patlab-ucsd/artemia_hardware/(threads)

Thread 1 (2024-05-21):

SWD header is mirrored!

gemarcano, 2024-05-21:
Workaround: mount it below the board.

What it is right now:
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

What it's supposed to be:
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

Closed 2024-11-22.

Thread 2 (2024-05-22):

Pin out some GPIOs for general purpose use/workarounds

gemarcano, 2024-05-22:
It'd be nice to have at least some GPIOs for testing purposes and bootloader workarounds pinned out...

Thread 3 (2024-05-22):

Explore giving every major region it's own individual ground plane for power measurement purposes

gemarcano, 2024-05-22:
Our RocketLoggers do best in low-side power sensing, which means we need to monitor the current in the return path. To do this, we need to effectively isolate the grounds of every major component.

How do we link up all of the grounds? Other than at a single point, just have them join some central "main" ground?

ppannuto, 2024-05-22:
The imix board ( https://github.com/helena-project/imix ) had separably measurable power for subsystems (radio, crypto stuff, core, maybe others IIRC) and can be a reference example of how to do this

ppannuto, 2024-05-22:
You can ping hudson on tock slack at some point as well if you have any specific design questions — he spent a rev or two getting all that right if memory serves

gemarcano, 2024-11-26:
I'm actually thinking about doing this by modularizing the board a little for lab use. Specifically, all of the SPI bus components can probably be uplifted to their own breakout/PCBs that plug into the motherboard. This makes it possible to also swap out things on the bus, and facilitates measuring the current of those peripherals. I'm also thinking of doing something similar for the input power areas.

For the larger/mother board, I'd probably do something like what Janet did for her board, where major areas are in their own ground planes, and they all converge at a point, allowing for low-side power measurements.

Thread 5 (2024-06-05):

Should we place the artemia firmware in the same repository as the hardware?

gemarcano, 2024-06-05:
I've done this before with other projects, as I find that it makes some sense. We can pull in the software via `git subtree` at a later date if we so choose.

ppannuto, 2024-06-05:
I usually find monorepos the way to go usually until proven necessary to do otherwise (in which case filter-tree can undo :) )

Thread 6 (2024-06-25):

Pulldown resistors on open-drain lines are causing issues, R18 and R19

gemarcano, 2024-06-25:
R18 and R19 is meant to ensure that the flip-flop has a well known low signal on two of its pins... but these are in lines that are open drain. The open drain pull up resistors with these ones effectively form unwanted voltage dividers. A workaround for now is to just remove them, although we think the long-term solution could well be to just remove R18 and R19...

Closed 2024-11-22.

Thread 7 (2024-06-25):

Q1 and Q2 footprint pins are wrong

gemarcano, 2024-06-25:
I used the wrong mapping of pin to function, Source and Gate are flipped. Refer to the BSS123 datasheets for more information about pin numbering and function.

gemarcano, 2024-06-25:
Actually, all 3 pins are wrong.

Closed 2024-11-22.

Thread 8 (2024-11-22):

Allow powering off peripherals completely

gemarcano, 2024-11-22:
To enable deep-sleep function, we need a way to completely turn off power to peripherals (flash, microphone, sensors, etc.). The question is, do we want them all to be on one rail, or have them be separate? Separate is nice, but each rail would need an IC, and that would increase the quiescent draw of the board by about 1uW per IC.

ppannuto, 2024-11-25:
I think one switch is the way to go for the short term. In the universe of multi-rail, at that point, should probably go for some full-fledged PMIC (e.g. https://www.renesas.com/en/document/dst/da9073-datasheet?r=1564746), where you can tune output voltage for each peripheral rail as well — and then we're adding a lot of complexity.

Is there a scenario where some peripheral (e.g. microphone) would want to be on during deep sleep, but the others would not? (And is it the case, perhaps, that `microphone_iq` << `flash_iq`, so we can just leave that one always-on?)

gemarcano, 2024-11-26:
PMICs are something I've been meaning to learn more about, but they do seem overkill in this situation. The standby/sleep current of most peripherals is low-ish (10-20 microwatts each). I'm not sure I'd want them on while the system is sleeping, although, it depends on what we define as sleep. If sleep is running off 10 microwatts, everything must be off. If sleep is shutting down most of the Artemis to save power while slow peripherals finish doing things, then yeah, we probably want to keep power on to those peripherals.

Thread 10 (2024-12-05):

Modularize entire board for lab use

gemarcano, 2024-12-05:
Maybe we need a new board, but effectively I want to modularize the board such that there is a motherboard everything plugs into. This is terrible for field deployment, but ideal for prototyping in the lab.

Specifically, I'm picturing something like:

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

The gist of it is that all connections to the motherboard should be modular. I'm a little unsure if we want to also make power control modular or just build that into the motherboard. I'm not sure how that'd even look. That said, because all the main busses go through the motherboard, I think it'd be reasonable for the motherboard to also control power and isolation.

# Isolation

In a perfect world I'd love for the motherboard to do isolation properly, e.g. using buffer ICs with enable signals to prevent parasitic power drain by peripherals when the buffers are disabled. Thing is, every IC adds some quiescent current. Currently I think it's "fine" to require software to turn off SPI busses before removing power to the bus.

# Power management

I think the more reasonable power control is to control each main bus separately. As an example, all peripherals on SPI bus 1 share VCC, so they're all either on or off. Same with SPI bus 2. But this way bus 1 and 2 can be turned on and off independently of each other. Other busses would have their own power control (not sure _if_ there are other busses, but PDM should probably also have its own power control). This effectively deals with #8.

# Busses

Right now we use 2 SPI busses on Artemia. It'd be nice to add a microphone, which would sit on the PDM bus/line. Should we bother breaking out i2c?

We should probably expose an "ADC bus" of some kind, to allow for analog sensors to be plugged into the board.

# Artemia

This exercise would truly help to make Artemia a proper module, as it'd just plug into a SPI bus and it'd power itself until main bus power is turned on. #

# Power measurement

By making peripherals and other stuff modular, it should be easier to interpose ourselves to power lines on modules and record power draw, addressing #3.

# GPIO

At the risk of making this too much like a dev-kit, it'd be nice to expose at least _some_ GPIOs for external use and debugging. Not sure how many we want to expose yet.

# MCU module

I'm... not sure if we want to make this too general or just key it in to the exact number of pins used by the Redboard Artemis. At a _minimum_ it should expose all of the busses we need/want, plus power control plus power inputs (VCC, GND).

gemarcano, 2024-12-06:
Doing this "the Right Way" requires making multiple boards, which means multiple KiCad projects. Just something to keep in mind.
