patlab-ucsd/artemia_hardware/design/artemia.pdf

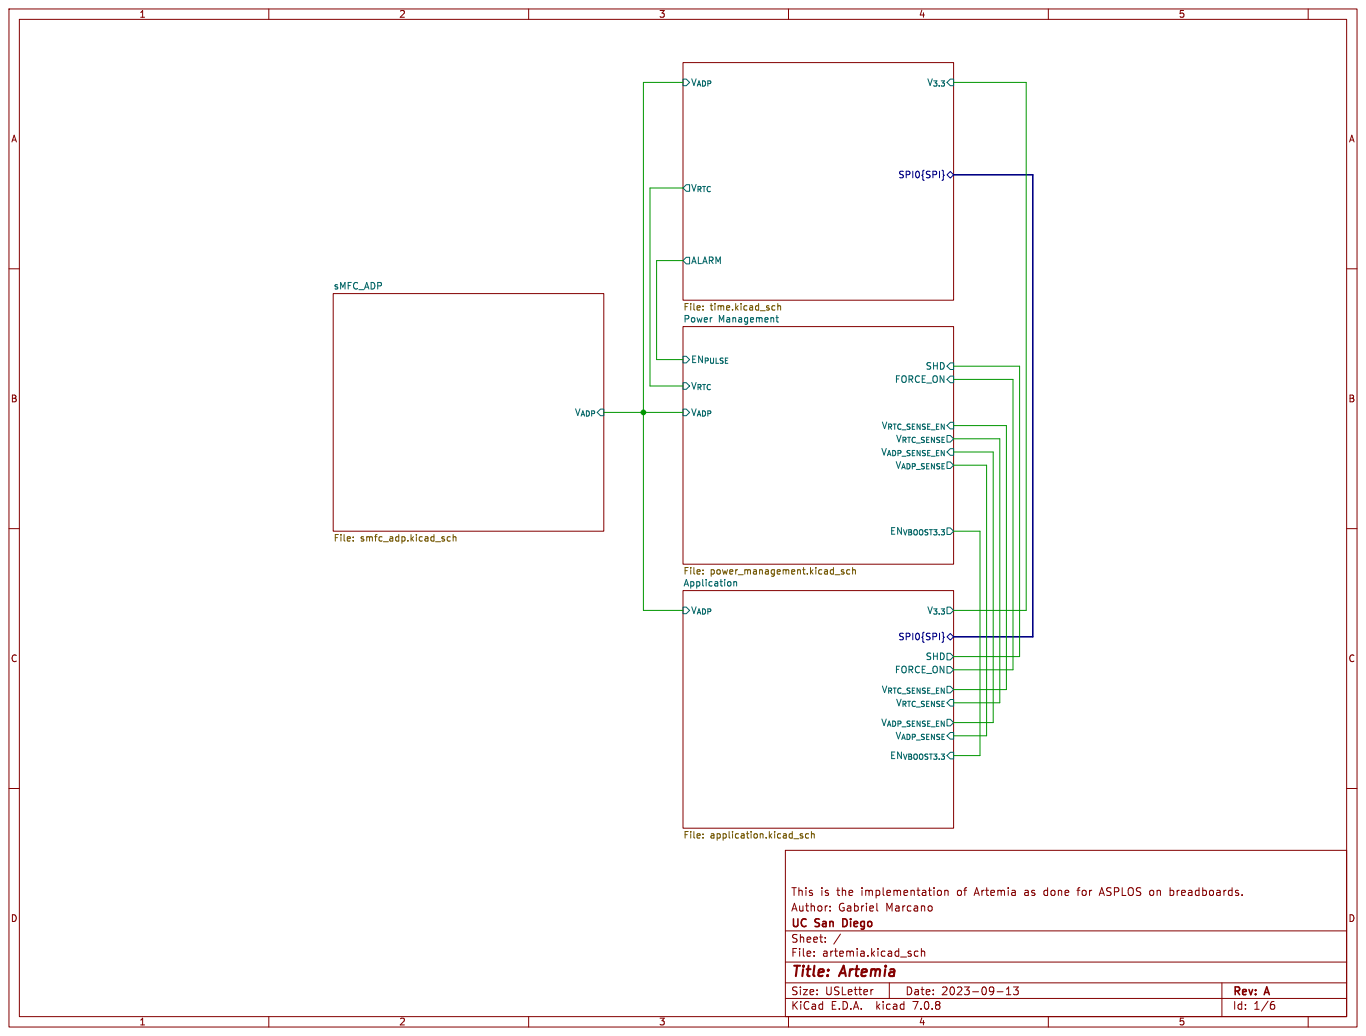
[picture p1: page 1]

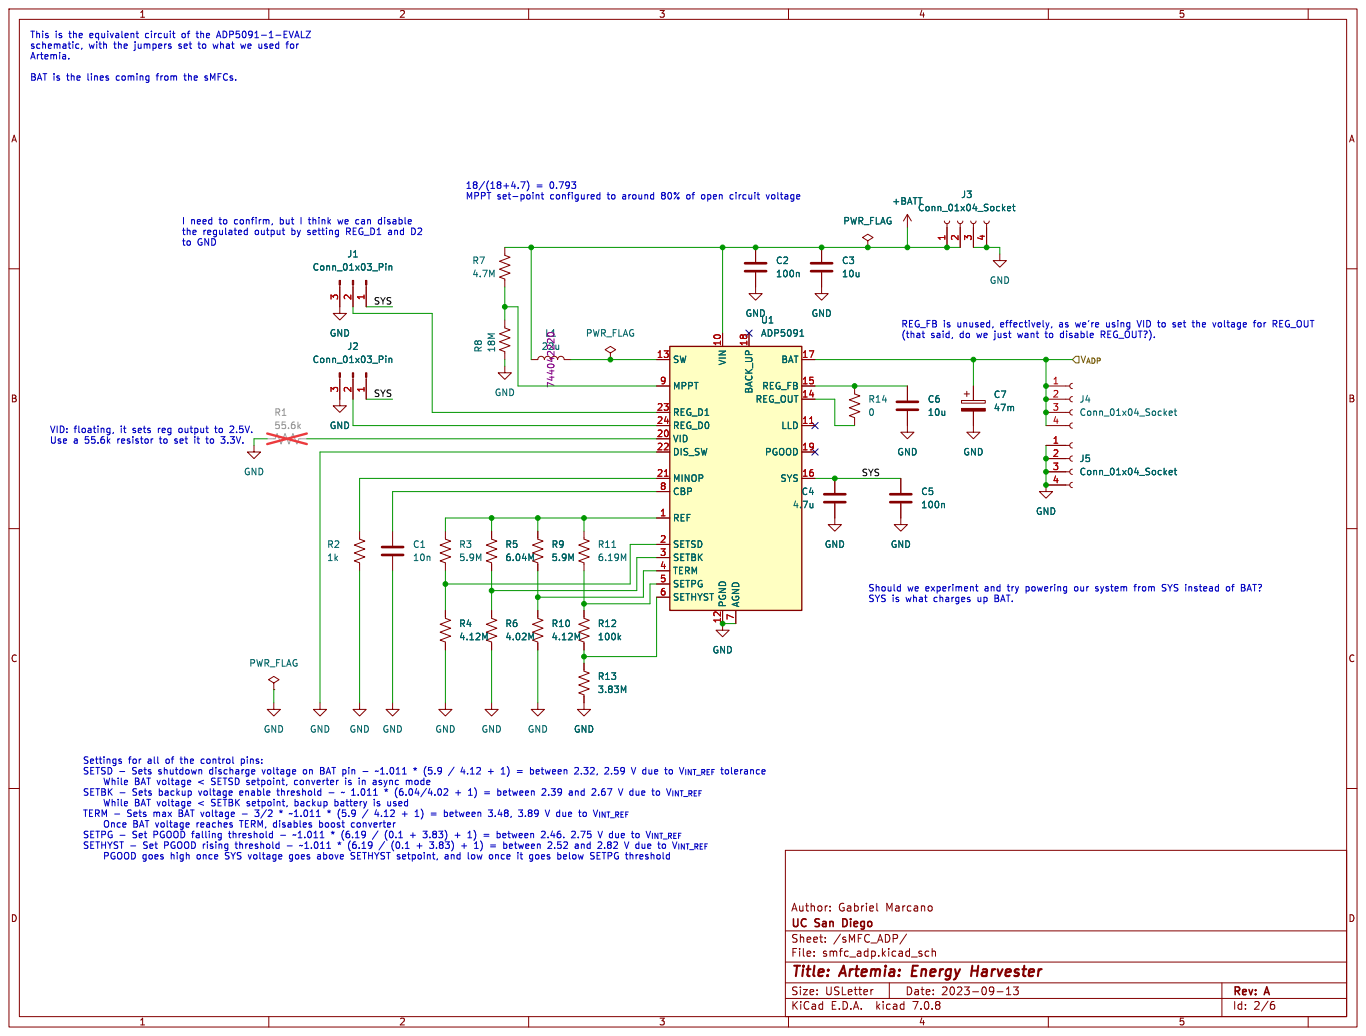
[picture p2: page 2]

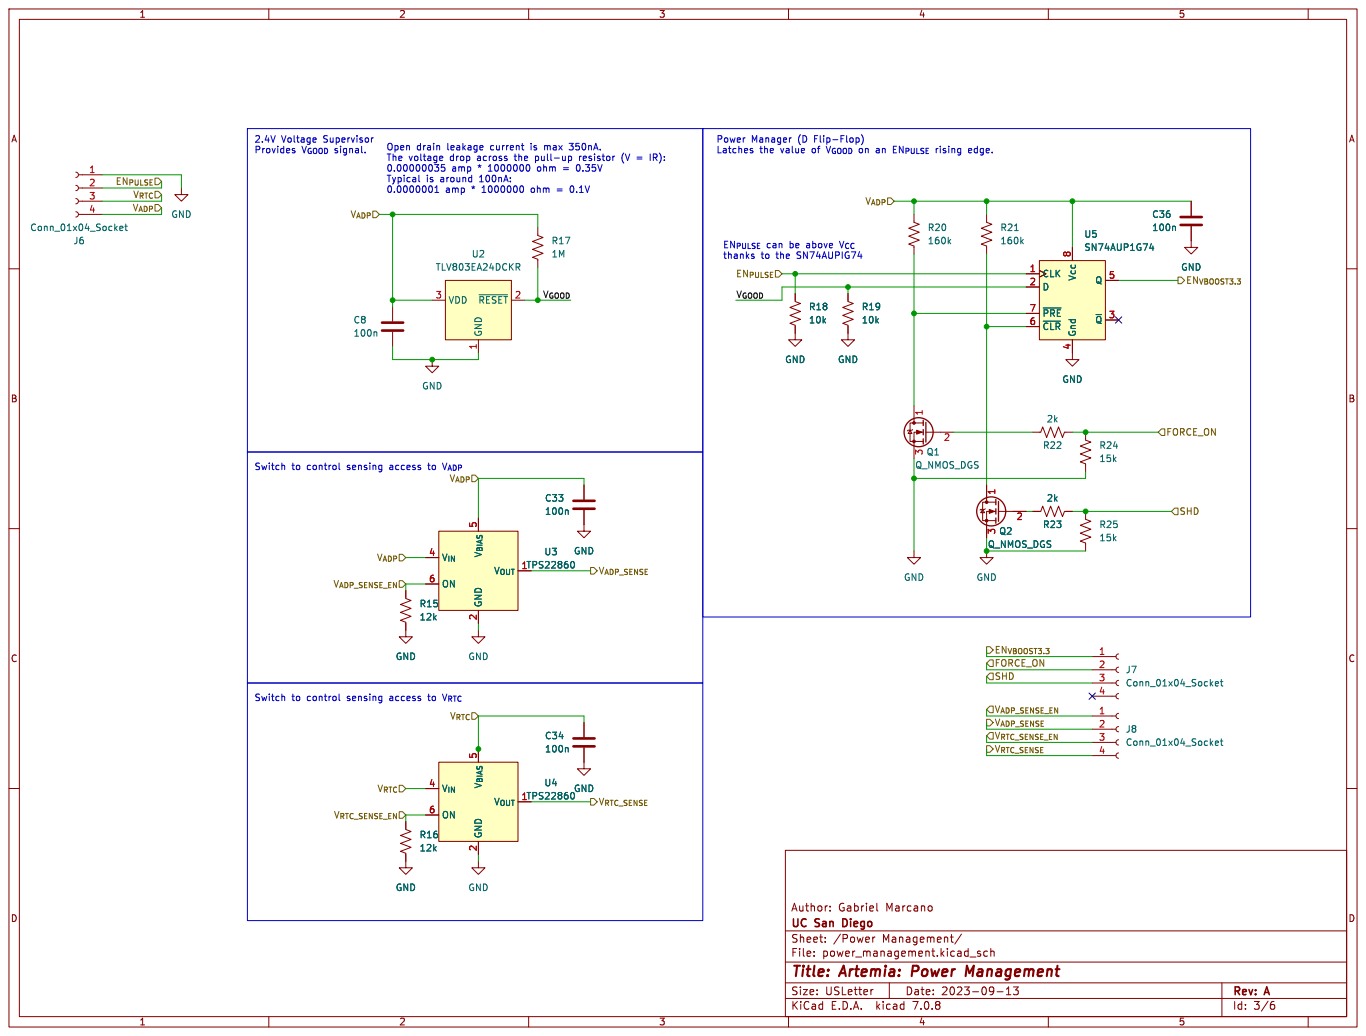
[picture p3: page 3]

Power Manager (D Flip-Flop) Latches the value of V_{GOOD} on an EN_{PULSE} rising edge.

EN_{PULSE} can be above V_{CC}

2 V_{IN} 4 V_{BIAS} 5 ON 6 U3 TPS22860 GND

2 V_{IN} 4 V_{BIAS} 5 ON 6 GND

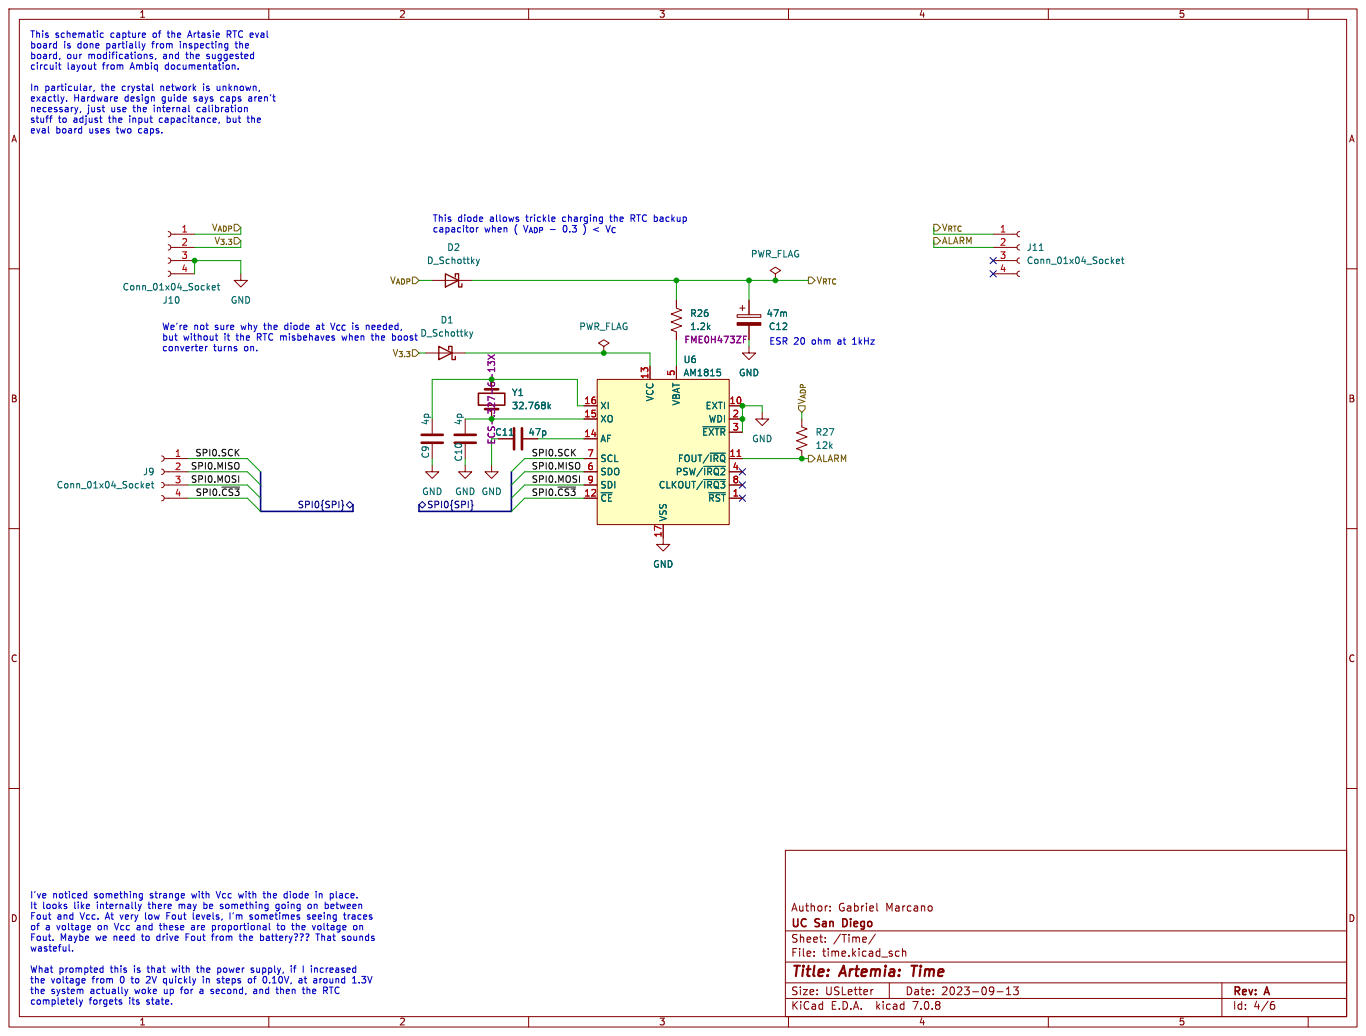
[picture p4: page 4]

5 SDO 6 SCL 7 CLKOUT/~{IRQ3}8 SDI 9 U6AM1815 GND GND C10 4p R26

5 SDO 6 SCL 7 CLKOUT/~{IRQ3}8 SDI 9 GND

the voltage from 0 to 2V quickly in steps of 0.10V, at around 1.3V

Id: 4/6 Title: Artemia: Time

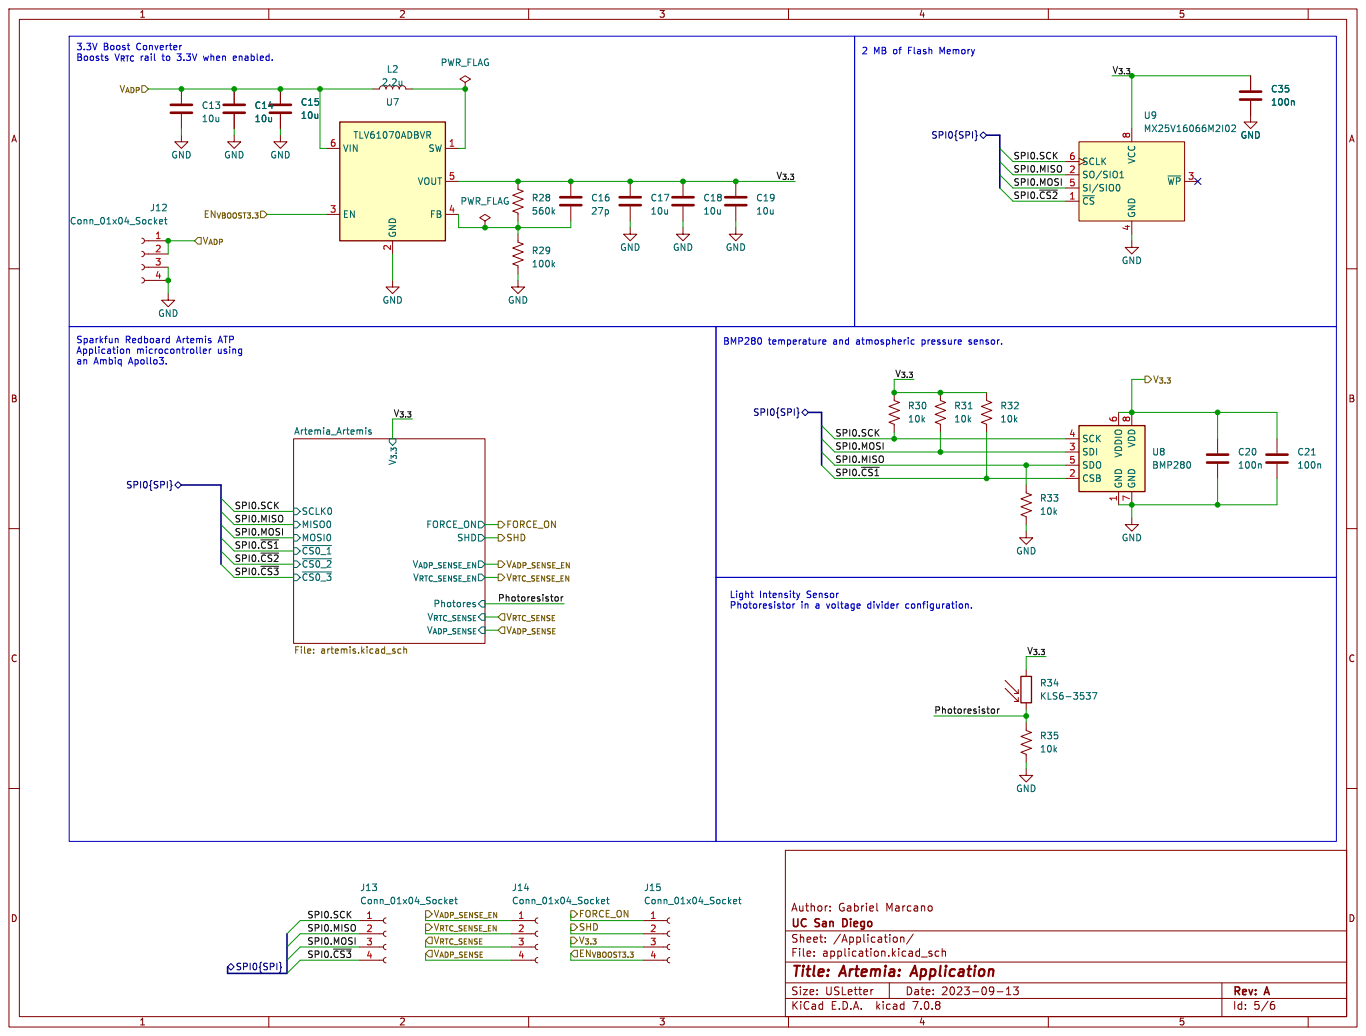
[picture p5: page 5]

3.3V Boost Converter Boosts V_{RTC} rail to 3.3V when enabled. Sparkfun Redboard Artemis ATP

2 EN 3 FB 4 VOUT 5 VIN 6 U7 TLV61070ADBVR GND

1 CSB 2 SDI 3 SCK 4 SDO 5 VDDIO

Id: 5/6 Title: Artemia: Application

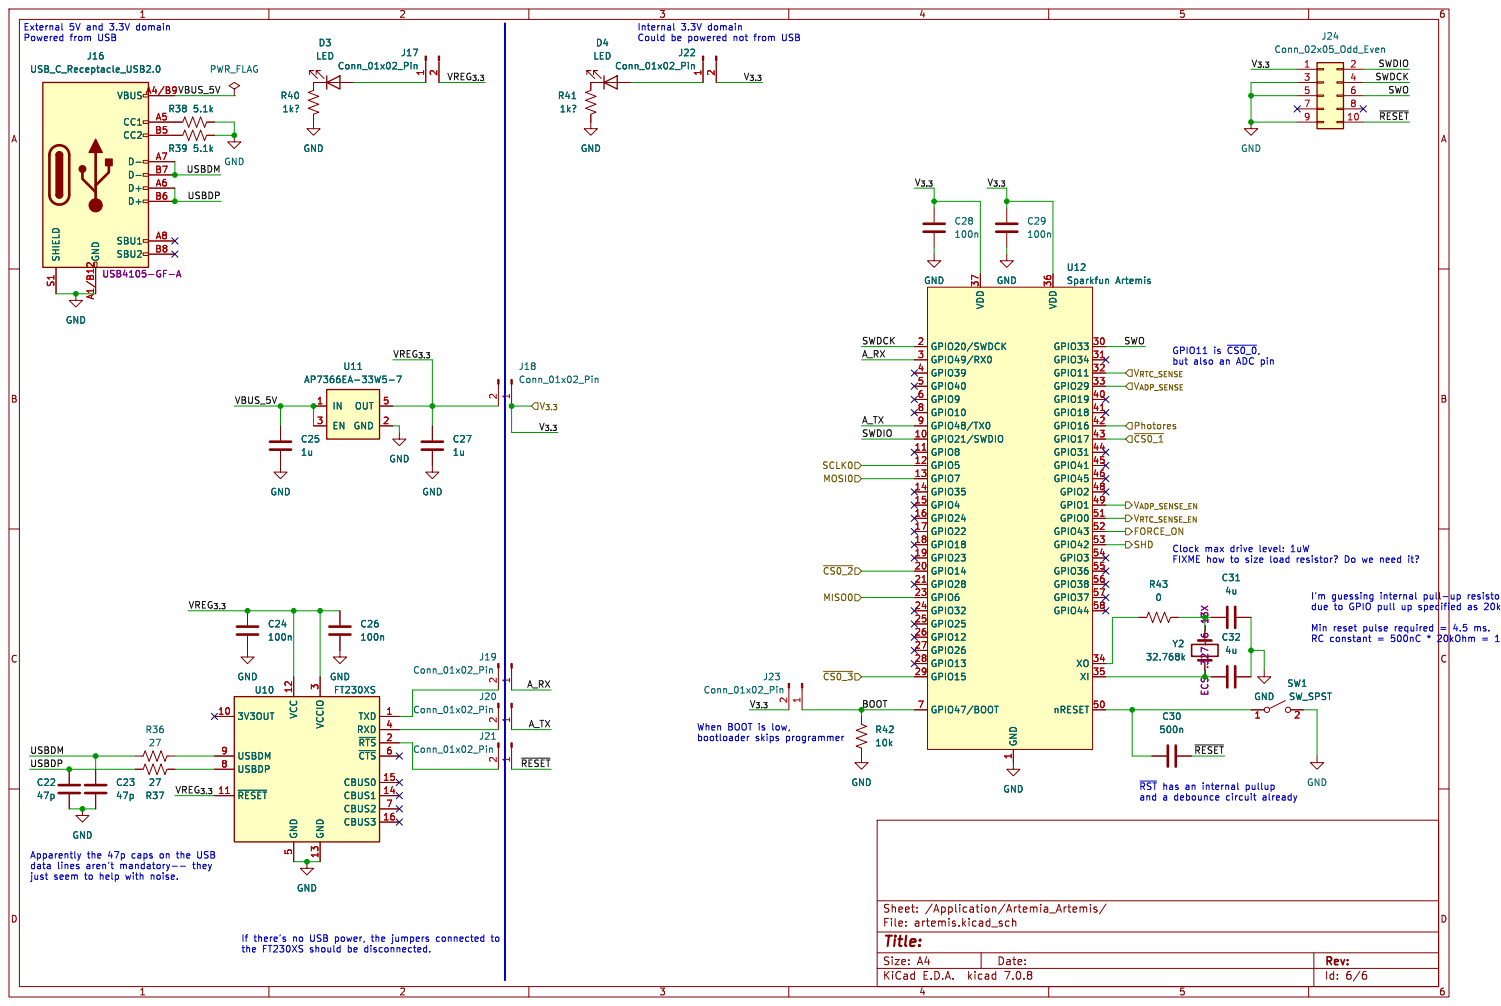
[picture p6: page 6]

External 5V and 3.3V domain Powered from USB

1 GPIO21/SWDIO 10 GPIO8 11 GPIO5 12 GPIO7 13 GPIO35 14 GPIO4 15 GPIO24 16 GPIO22 17 GPIO18 18 GPIO23 19 GPIO20/SWDCK 2 GPIO14 20 GPIO28 21 GPIO6 23 GPIO32 24 GPIO25 25 GPIO12 26 GPIO26 27 GPIO13 28 GPIO15 29 GPIO49/RX0 3 GPIO33 30 GPIO34 31 GPIO11 32 GPIO29 33 XO 34 XI 35 VDD 36 VDD 37 GPIO39 4 GPIO19 40 GPIO18 41 GPIO16 42 GPIO17 43 GPIO31 44 GPIO41 45 GPIO45 46 GPIO2 48 GPIO1 49 GPIO40 5

Id: 6/6 Title: File: artemis.kicad_sch Sheet: /Application/Artemia_Artemis/

the FT230XS should be disconnected.
