patlab-ucsd/artemia_hardware/design/PCB/artemia_pcb.pdf

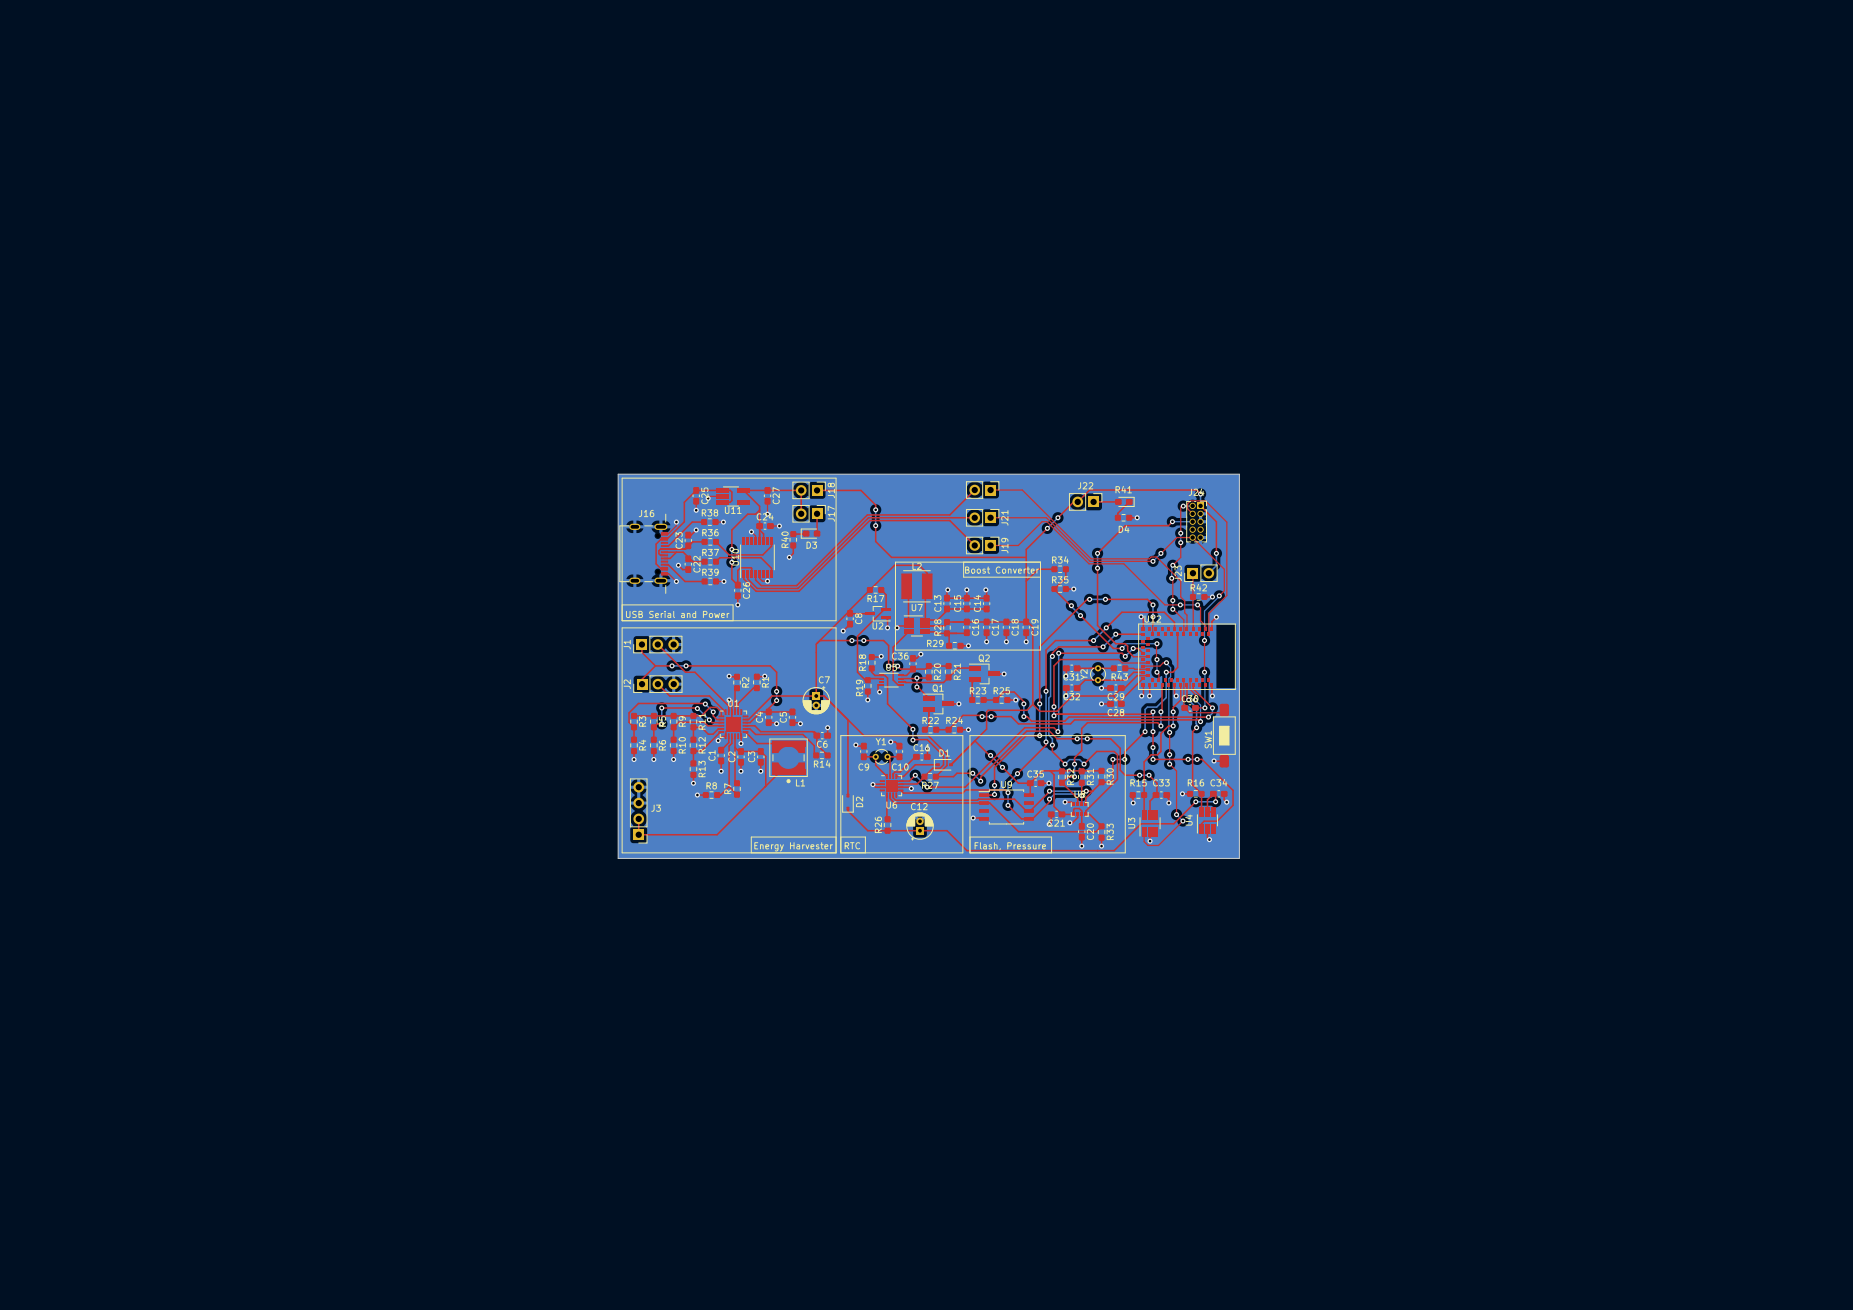
[picture p7: page 1]
