patlab-ucsd/artemia_hardware/(commit log)

2023-10-24 Layout cleanups, add more component data
    - Selected part for USB C socket
    - Tried to make more of the schematics compact and modular
    [artemis.kicad_sch, power_management.kicad_sch, smfc_adp.kicad_sch, time.kicad_sch]
2023-10-31 First routing attempt
    [application.kicad_sch, artemia.kicad_pcb, artemis.kicad_sch, power_management.kicad_sch, smfc_adp.kicad_sch, time.kicad_sch]
2023-11-14 Move traces away from clock area
    - Move SPI and other traces away from the low frequency clock area. Not
    that it matters too much as the clock is ~30kHz, but still try to
    keep some semblance of signal integrity
    [artemia.kicad_pcb]
2023-11-14 Add WIP PDF schematic
2023-11-14 Add WIP PCB pdfs
2023-11-15 Project: add folder for design files
    [artemia.kicad_pcb]
2024-01-19 Add FIXMEs, improve info on PCB silkscreen
    - Added more information about what all of the headers are on the board
    - Need to review footprints for clocks and capacitors!
    - Moved some lines around to try to get them to line up to the grid
    - Need to split the 01x04 connector for BAT/GND, annotated with FIXME
    [artemia.kicad_pcb, smfc_adp.kicad_sch]
2024-04-16 Added LoRa module, lots of fixes & tweaks
    - Added loRa module as last Artemia experiment uses LoRa RFM95W
    - Added headers for debuggging purposes
    - Expanded board size to account for added hardware
    - Updated clearances to match JLCPCB manufacturing capabilities (I
    figure that if JLCPCB can fab it, anyone else can)
    - Fixed DRC issues (still need to run analysis on schematic)
    [application.kicad_sch, artemia.kicad_pcb, artemia.kicad_sch, artemis.kicad_sch, power_management.kicad_sch, smfc_adp.kicad_sch, time.kicad_sch]
2024-04-16 Change line-endings to Unix
    [application.kicad_sch, artemia.kicad_pcb, artemia.kicad_sch, artemis.kicad_sch, power_management.kicad_sch, smfc_adp.kicad_sch, time.kicad_sch]
2024-04-17 Tweaks to routing, add LoRa switch enable
    - Trying to avoid GND islands near the Artemis module, tweaking traces
    to allow enough space for the ground plane to make it uninterrupted
    throught the entire board.
    - Actually wire LoRa switch enable. I need to confirm the max current
    pulled by LoRa module is supported by switch (I think so, but
    barely).
    [artemia.kicad_pcb, artemis.kicad_sch]
2024-04-19 Add more informative text, crystal to SMD, headers
    - Added a lot more to the silkscreen to segment parts of the board
    - Changed the 32kHz crystals to an SMD part
    - Added some headers for ADP5091 function
    - Some BOM consolidation, mostly of resistors and capacitors
    - Marked one capacitor as C0G rating
    [application.kicad_sch, artemia.kicad_pcb, artemis.kicad_sch, power_management.kicad_sch, smfc_adp.kicad_sch, time.kicad_sch]
2024-04-21 Fix ERC, add MPN and datasheet information
    [application.kicad_sch, artemia.kicad_pcb, artemis.kicad_sch, power_management.kicad_sch, smfc_adp.kicad_sch, time.kicad_sch]
2024-04-21 Update datasheet and MPN for C and R
    - Update pin headers from sockets to pins
    [application.kicad_sch, artemia.kicad_pcb, artemis.kicad_sch, power_management.kicad_sch, smfc_adp.kicad_sch, time.kicad_sch]
2024-04-21 Replace photodiode with phototransistor
    - Can't find original photoresistor online, I think we can use this
    phototransistor as a similar device
    [application.kicad_sch, artemia.kicad_pcb]
2024-04-21 Replace BMP280 with BME280
    - Apparently the BME280 is pin compatible with the BMP280, although
    it may require some software changes. BMP280 is obsolete and no
    longer being manufactured.
    [application.kicad_sch, artemia.kicad_pcb]
2024-04-21 Fix Artemis module product number
    - I accidentally was using the engineering product number, which is out
    of stock everywhere. Use the right product number, this way
    manufacturers reading the BOM can actually find it...
    [artemia.kicad_pcb, artemis.kicad_sch]
2024-04-22 Fix RESET cap value, update footprint courtyards
    - Mostly adding courtyards, and cleaning up some silkscreens
    - Change from 500nF capacitor that doesn't exist to 470nF for DTS-
    triggered reset of MCU
    [artemia.kicad_pcb, artemia.kicad_sch, artemis.kicad_sch, power_management.kicad_sch]
2024-05-14 Fix artemis symbol
    - Turns out there were 2 typos in the artemis symbol, errors on pins 18
    and 19. Correct them on the symbol. Thankfully, it looks like we'll
    be able to work around the typos in software.
    [artemis.kicad_sch]
2024-11-21 Fix BSS123 pins, remove R18 R19 pulldowns
    - BSS123 pinout were completely wrong due to using the wrong symbol in
    the schematic. Made a new symbol with the right pinout. Fixes #7.
    - R18 and R19 were forming a voltage divider as V_GOOD and EN_PULSE
    are open-drain lines. Remove the pull-downs, and pray that circuit
    initialization is sane. Fixes #6.
    [application.kicad_sch, artemia.kicad_sch, artemis.kicad_sch, power_management.kicad_sch, smfc_adp.kicad_sch, time.kicad_sch]
2024-11-22 Update PCB to match recent schematic changes
    [artemia.kicad_pcb]
2024-11-22 Fix SWD pinout in PCB
    - SWD pinout was mirrored from what it should have been. Made a new
    footprint to match the real pinout specification. Fixes #1.
    [artemia.kicad_pcb, artemis.kicad_sch]
